Anggito007/hidroponik-iot/skematik.md

# Panduan Skematik HydroIoT
## Referensi Wiring untuk EasyEDA / Fritzing

---

# BAGIAN 1 — DESAIN SISTEM NODE (LENGKAP)

## 1.1 Diagram Sistem Node (Koneksi Fisik)

```
                        ┌─────────────────────────────────────────────────────────────────┐
                        │                    SISTEM NODE HIDROPONIK                        │
                        │                  (Node 1 ADDL=0x02 / Node 2 ADDL=0x03)          │
                        └─────────────────────────────────────────────────────────────────┘

┌──────────────────┐    ┌──────────────────────────────────────────────────────────────────┐
│   ADAPTOR 9V DC  │    │                    ESP32 EXPANSION BOARD                         │
│                  │    │                                                                   │
│  (+) ────────────┼───►│ VIN                                                              │
│  (-) ────────────┼───►│ GND ◄─────────────────────────────────── PSU 12V (-)            │
└──────────────────┘    │                                                                   │
                        │  3.3V ─────────────────────────────────────────────────────┐     │
                        │  5V   ──────────────────────────────────────────────────┐  │     │
                        │  GND  ──────────────────────────────────────────────┐   │  │     │
                        │                                                     │   │  │     │
                        │  ┌──────────────────────────────────────────────┐  │   │  │     │
                        │  │              LoRa E32-433T20D                 │  │   │  │     │
                        │  │  VCC ◄─────────────────────────────────── 5V ┼──┘   │  │     │
                        │  │  GND ◄──────────────────────────────────────GND     │  │     │
                        │  │  RXD ◄──── GPIO17 (TX2)                      │      │  │     │
                        │  │  TXD ────► GPIO16 (RX2)                      │      │  │     │
                        │  │  AUX ────► GPIO18                             │      │  │     │
                        │  │  M0  ◄──── GPIO21                             │      │  │     │
                        │  │  M1  ◄──── GPIO22                             │      │  │     │
                        │  └──────────────────────────────────────────────┘      │  │     │
                        │                                                         │  │     │
                        │  ┌──────────────────────────────────────────────┐      │  │     │
                        │  │                   DHT22                       │      │  │     │
                        │  │  Pin1 VCC  ◄──────────────────────────── 3.3V┼──────┘  │     │
                        │  │  Pin2 DATA ────► GPIO4 (INPUT_PULLUP)         │         │     │
                        │  │  Pin3 NC   (tidak disambung)                  │         │     │
                        │  │  Pin4 GND  ◄────────────────────────────────GND        │     │
                        │  └──────────────────────────────────────────────┘         │     │
                        │                                                            │     │
                        │  ┌──────────────────────────────────────────────┐         │     │
                        │  │              HC-SR04 Ultrasonik               │         │     │
                        │  │  VCC  ◄──────────────────────────────────── 5V┼─────────┘     │
                        │  │  GND  ◄────────────────────────────────────GND               │
                        │  │  TRIG ◄──── GPIO32                            │               │
                        │  │  ECHO ──── [R1:1kΩ] ──── GPIO33               │               │
                        │  │                │                               │               │
                        │  │            [R2:2kΩ]                            │               │
                        │  │                │                               │               │
                        │  │               GND                              │               │
                        │  └──────────────────────────────────────────────┘               │
                        │                                                                   │
                        │  ┌──────────────────────────────────────────────┐               │
                        │  │            Modul TDS Sensor                   │               │
                        │  │  VCC  ◄──────────────────────────────────── 5V│               │
                        │  │  GND  ◄────────────────────────────────────GND│               │
                        │  │  AOUT ────► GPIO35 (ADC)                      │               │
                        │  └──────────────────────────────────────────────┘               │
                        │                                                                   │
                        │  ┌──────────────────────────────────────────────┐               │
                        │  │          Modul Relay 3 Channel                │               │
                        │  │  VCC ◄───────────────────────────────────── 5V│               │
                        │  │  GND ◄─────────────────────────────────────GND│               │
                        │  │  IN1 ◄──── GPIO23 (Pompa Air)                 │               │
                        │  │  IN2 ◄──── GPIO25 (Pompa Nutrisi)             │               │
                        │  │  IN3 ◄──── GPIO26 (Kipas)                     │               │
                        │  │                                                │               │
                        │  │  COM1 ◄─── PSU 12V (+) ───────────────────────┼───────────────┼──┐
                        │  │  COM2 ◄─── PSU 12V (+)                        │               │  │
                        │  │  COM3 ◄─── PSU 12V (+)                        │               │  │
                        │  │                                                │               │  │
                        │  │  NO1 ──────────────────────────────────────────┼───► (+) Pompa Air
                        │  │  NO2 ──────────────────────────────────────────┼───► (+) Pompa Nutrisi
                        │  │  NO3 ──────────────────────────────────────────┼───► (+) Kipas
                        │  └──────────────────────────────────────────────┘               │  │
                        └───────────────────────────────────────────────────────────────────┘  │
                                                                                               │
┌──────────────────┐                                                                           │
│   PSU 12V DC     │                                                                           │
│  (+) ────────────┼───────────────────────────────────────────────────────────────────────────┘
│  (-) ────────────┼───► GND ESP32 (Common GND)
│                  │───► (-) Pompa Air
│                  │───► (-) Pompa Nutrisi
└──────────────────┘───► (-) Kipas
```

---

## 1.2 Diagram Koneksi Voltage Divider HC-SR04

```
HC-SR04 ECHO (5V)
        │
       [R1: 1kΩ]
        │
        ├──────────────► GPIO33 ESP32 (3.3V max)
        │
       [R2: 2kΩ]
        │
       GND

Vout = 5V × 2000/(1000+2000) = 3.33V ✓
```

---

## 1.3 Diagram Power Distribution Node

```
┌─────────────────────────────────────────────────────────┐
│                  DISTRIBUSI DAYA NODE                    │
│                                                          │
│  ADAPTOR 9V                                              │
│  (+) ──────────────────────────────► VIN ESP32           │
│  (-) ──────┬───────────────────────► GND ESP32           │
│            │                                             │
│  PSU 12V   │                                             │
│  (+) ──────┼──────────────────────► COM Relay 1,2,3      │
│  (-) ──────┘ (COMMON GND)                                │
│            │                                             │
│            ├──────────────────────► (-) Pompa Air        │
│            ├──────────────────────► (-) Pompa Nutrisi    │
│            └──────────────────────► (-) Kipas            │
│                                                          │
│  Board Ekspansi ESP32 output:                            │
│  5V  ──► LoRa E32, HC-SR04, TDS Sensor, Relay           │
│  3.3V──► DHT22                                           │
└─────────────────────────────────────────────────────────┘
```

---

# BAGIAN 2 — DESAIN SISTEM GATEWAY

## 2.1 Diagram Sistem Gateway (Koneksi Fisik)

```
                        ┌─────────────────────────────────────────────────────────────────┐
                        │                       SISTEM GATEWAY                             │
                        │                    (ADDL=0x01, WiFi → Firebase)                 │
                        └─────────────────────────────────────────────────────────────────┘

┌──────────────────┐    ┌──────────────────────────────────────────────────────────────────┐
│   ADAPTOR 9V DC  │    │                    ESP32 EXPANSION BOARD                         │
│                  │    │                                                                   │
│  (+) ────────────┼───►│ VIN                                                              │
│  (-) ────────────┼───►│ GND                                                              │
└──────────────────┘    │                                                                   │
                        │  5V ────────────────────────────────────────────────────────┐    │
                        │  GND ───────────────────────────────────────────────────┐   │    │
                        │                                                         │   │    │
                        │  ┌──────────────────────────────────────────────┐      │   │    │
                        │  │              LoRa E32-433T20D                 │      │   │    │
                        │  │  VCC ◄─────────────────────────────────── 5V ┼──────┘   │    │
                        │  │  GND ◄──────────────────────────────────────GND         │    │
                        │  │  RXD ◄──── GPIO17 (TX2)                      │          │    │
                        │  │  TXD ────► GPIO16 (RX2)                      │          │    │
                        │  │  AUX ────► GPIO18                             │          │    │
                        │  │  M0  ◄──── GPIO21                             │          │    │
                        │  │  M1  ◄──── GPIO22                             │          │    │
                        │  └──────────────────────────────────────────────┘          │    │
                        │                                                             │    │
                        │  ┌──────────────────────────────────────────────┐          │    │
                        │  │           WiFi Internal ESP32                 │          │    │
                        │  │  SSID: Tenda                                  │          │    │
                        │  │  Fungsi: Push sensor data ke Firebase         │          │    │
                        │  │          Poll relay command dari Firebase     │          │    │
                        │  └──────────────────────────────────────────────┘          │    │
                        └─────────────────────────────────────────────────────────────┘    │
```

---

## 2.2 Diagram Power Distribution Gateway

```
┌─────────────────────────────────────────────────────────┐
│               DISTRIBUSI DAYA GATEWAY                    │
│                                                          │
│  ADAPTOR 9V                                              │
│  (+) ──────────────────────────────► VIN ESP32           │
│  (-) ──────────────────────────────► GND ESP32           │
│                                                          │
│  Board Ekspansi ESP32 output:                            │
│  5V  ──► LoRa E32                                        │
│  3.3V──► GPIO (internal)                                 │
└─────────────────────────────────────────────────────────┘
```

---

# BAGIAN 3 — DESAIN KONEKSI PER KOMPONEN

## 3.1 ESP32 ↔ LoRa E32-433T20D

```
┌─────────────────┐              ┌─────────────────────┐
│      ESP32      │              │   LoRa E32-433T20D   │
│                 │              │                      │
│ GPIO17 (TX2) ───┼─────────────►│ RXD                  │
│ GPIO16 (RX2) ◄──┼──────────────│ TXD                  │
│ GPIO18       ◄──┼──────────────│ AUX                  │
│ GPIO21       ───┼─────────────►│ M0                   │
│ GPIO22       ───┼─────────────►│ M1                   │
│ 5V           ───┼─────────────►│ VCC                  │
│ GND          ───┼─────────────►│ GND                  │
└─────────────────┘              └─────────────────────┘
```

## 3.2 ESP32 ↔ DHT22

```
┌─────────────────┐              ┌─────────────────────┐
│      ESP32      │              │        DHT22         │
│                 │              │  (tampak depan)      │
│ 3.3V         ───┼─────────────►│ Pin 1 (VCC)          │
│ GPIO4        ◄──┼──────────────│ Pin 2 (DATA)         │
│ -               │    (skip)    │ Pin 3 (NC)           │
│ GND          ───┼─────────────►│ Pin 4 (GND)          │
└─────────────────┘              └─────────────────────┘

Catatan: Internal pull-up ESP32 aktif di firmware
         Tidak perlu resistor pull-up eksternal
```

## 3.3 ESP32 ↔ HC-SR04

```
┌─────────────────┐              ┌─────────────────────┐
│      ESP32      │              │      HC-SR04         │
│                 │              │                      │
│ 5V           ───┼─────────────►│ VCC                  │
│ GND          ───┼─────────────►│ GND                  │
│ GPIO32       ───┼─────────────►│ TRIG                 │
│                 │              │ ECHO ──[1kΩ]──┐      │
│ GPIO33       ◄──┼──────────────┘               │      │
│                 │                          [2kΩ]│      │
│ GND          ───┼──────────────────────────────┘      │
└─────────────────┘              └─────────────────────┘
```

## 3.4 ESP32 ↔ TDS Sensor

```
┌─────────────────┐              ┌─────────────────────┐
│      ESP32      │              │   Modul TDS Sensor   │
│                 │              │                      │
│ 5V           ───┼─────────────►│ VCC                  │
│ GND          ───┼─────────────►│ GND                  │
│ GPIO35       ◄──┼──────────────│ AOUT                 │
└─────────────────┘              └─────────────────────┘

Catatan: GPIO35 = ADC input only, output TDS max ~2.3V
         Tidak perlu voltage divider
```

## 3.5 ESP32 ↔ Modul Relay 3 Channel

```
┌─────────────────┐              ┌─────────────────────────────┐
│      ESP32      │              │    Modul Relay 3 Channel     │
│                 │              │    (Active LOW)              │
│ 5V           ───┼─────────────►│ VCC                         │
│ GND          ───┼─────────────►│ GND                         │
│ GPIO23       ───┼─────────────►│ IN1 (Relay 1 — Pompa Air)   │
│ GPIO25       ───┼─────────────►│ IN2 (Relay 2 — Pompa Nutrisi│
│ GPIO26       ───┼─────────────►│ IN3 (Relay 3 — Kipas)       │
└─────────────────┘              └─────────────────────────────┘
```

## 3.6 Relay ↔ Beban 12V

```
PSU 12V (+) ──────────────────────────────────────────────────┐
                                                               │
              ┌────────────────────────────────────────────┐  │
              │  RELAY 1                                    │  │
              │  COM ◄────────────────────────────────────── ┘  │
              │  NO  ──────────────────────────────────────────►(+) Pompa Air
              └────────────────────────────────────────────┘

              ┌────────────────────────────────────────────┐
              │  RELAY 2                                    │
              │  COM ◄──── PSU 12V (+)                      │
              │  NO  ──────────────────────────────────────►(+) Pompa Nutrisi
              └────────────────────────────────────────────┘

              ┌────────────────────────────────────────────┐
              │  RELAY 3                                    │
              │  COM ◄──── PSU 12V (+)                      │
              │  NO  ──────────────────────────────────────►(+) Kipas
              └────────────────────────────────────────────┘

PSU 12V (-) ──────────────────────────────────────────────────►(-) Pompa Air
                                                              ──►(-) Pompa Nutrisi
                                                              ──►(-) Kipas
```

---

# BAGIAN 4 — TABEL KONEKSI LENGKAP

## 4.1 Node 1 & Node 2

| No | Dari | Pin | Ke | Pin | Tegangan |
|---|---|---|---|---|---|
| 1 | Adaptor 9V | (+) | ESP32 Board | VIN | 9V |
| 2 | Adaptor 9V | (-) | ESP32 Board | GND | - |
| 3 | PSU 12V | (+) | Relay | COM 1,2,3 | 12V |
| 4 | PSU 12V | (-) | ESP32 Board | GND | - |
| 5 | PSU 12V | (-) | Pompa Air | (-) | - |
| 6 | PSU 12V | (-) | Pompa Nutrisi | (-) | - |
| 7 | PSU 12V | (-) | Kipas | (-) | - |
| 8 | ESP32 | 5V | LoRa E32 | VCC | 5V |
| 9 | ESP32 | GND | LoRa E32 | GND | - |
| 10 | ESP32 | GPIO17 | LoRa E32 | RXD | 3.3V |
| 11 | ESP32 | GPIO16 | LoRa E32 | TXD | 3.3V |
| 12 | ESP32 | GPIO18 | LoRa E32 | AUX | 3.3V |
| 13 | ESP32 | GPIO21 | LoRa E32 | M0 | 3.3V |
| 14 | ESP32 | GPIO22 | LoRa E32 | M1 | 3.3V |
| 15 | ESP32 | 3.3V | DHT22 | Pin1 VCC | 3.3V |
| 16 | ESP32 | GND | DHT22 | Pin4 GND | - |
| 17 | ESP32 | GPIO4 | DHT22 | Pin2 DATA | 3.3V |
| 18 | ESP32 | 5V | HC-SR04 | VCC | 5V |
| 19 | ESP32 | GND | HC-SR04 | GND | - |
| 20 | ESP32 | GPIO32 | HC-SR04 | TRIG | 3.3V |
| 21 | HC-SR04 | ECHO | R1 1kΩ → GPIO33 | - | 5V→3.3V |
| 22 | ESP32 | 5V | TDS Sensor | VCC | 5V |
| 23 | ESP32 | GND | TDS Sensor | GND | - |
| 24 | ESP32 | GPIO35 | TDS Sensor | AOUT | 0-2.3V |
| 25 | ESP32 | 5V | Relay | VCC | 5V |
| 26 | ESP32 | GND | Relay | GND | - |
| 27 | ESP32 | GPIO23 | Relay | IN1 | 3.3V |
| 28 | ESP32 | GPIO25 | Relay | IN2 | 3.3V |
| 29 | ESP32 | GPIO26 | Relay | IN3 | 3.3V |
| 30 | Relay | NO1 | Pompa Air | (+) | 12V |
| 31 | Relay | NO2 | Pompa Nutrisi | (+) | 12V |
| 32 | Relay | NO3 | Kipas | (+) | 12V |

## 4.2 Gateway

| No | Dari | Pin | Ke | Pin | Tegangan |
|---|---|---|---|---|---|
| 1 | Adaptor 9V | (+) | ESP32 Board | VIN | 9V |
| 2 | Adaptor 9V | (-) | ESP32 Board | GND | - |
| 3 | ESP32 | 5V | LoRa E32 | VCC | 5V |
| 4 | ESP32 | GND | LoRa E32 | GND | - |
| 5 | ESP32 | GPIO17 | LoRa E32 | RXD | 3.3V |
| 6 | ESP32 | GPIO16 | LoRa E32 | TXD | 3.3V |
| 7 | ESP32 | GPIO18 | LoRa E32 | AUX | 3.3V |
| 8 | ESP32 | GPIO21 | LoRa E32 | M0 | 3.3V |
| 9 | ESP32 | GPIO22 | LoRa E32 | M1 | 3.3V |

---

# BAGIAN 5 — DAFTAR KOMPONEN (BOM)

## Per Node (×2)

| No | Komponen | Spesifikasi | Qty |
|---|---|---|---|
| 1 | ESP32 | DevKit + Board Ekspansi | 1 |
| 2 | LoRa E32 | E32-433T20D | 1 |
| 3 | DHT22 | Sensor Suhu & Kelembapan | 1 |
| 4 | HC-SR04 | Sensor Ultrasonik | 1 |
| 5 | TDS Sensor | Modul Kuning | 1 |
| 6 | Modul Relay | 3 Channel, 5V, Active LOW | 1 |
| 7 | Resistor | 1kΩ (voltage divider ECHO) | 1 |
| 8 | Resistor | 2kΩ (voltage divider ECHO) | 1 |
| 9 | Adaptor | 9V DC | 1 |
| 10 | PSU | 12V DC | 1 |
| 11 | Pompa Air | 12V DC | 1 |
| 12 | Pompa Nutrisi | 12V DC | 1 |
| 13 | Kipas | 12V DC | 1 |

## Gateway (×1)

| No | Komponen | Spesifikasi | Qty |
|---|---|---|---|
| 1 | ESP32 | DevKit + Board Ekspansi | 1 |
| 2 | LoRa E32 | E32-433T20D | 1 |
| 3 | Adaptor | 9V DC | 1 |
