Anggito007/hidroponik-iot/docs/PANDUAN_WIRING_LENGKAP.html

# 🔌 PANDUAN WIRING LENGKAP

## Sistem HydroIoT dengan ESP32 + Relay + LM2596

Versi: 2.0 | Tanggal: Juli 2026

### Daftar Isi

- 1. Overview Sistem
- 2. Komponen yang Dibutuhkan
- 3. Distribusi Daya (Power Distribution)
- 4. Penjelasan VCC vs JD-VCC
- 5. Konfigurasi Wiring yang Direkomendasikan
- 6. Wiring Ground (GND Bersama)
- 7. Wiring Beban 12V (Pompa & Kipas)
- 8. Masalah Umum & Solusi
- 9. Best Practices & Tips
- 10. Checklist Sebelum Nyala

## 1. Overview Sistem

Sistem HydroIoT menggunakan konfigurasi power sebagai berikut:

- PSU Utama: 12V DC
- Step-Down: LM2596 (12V → 5V untuk relay & ESP32)
- ESP32: Mikrokontroler utama
- Relay Module: 3-channel, 5V, active LOW dengan optocoupler
- Beban: Pompa air 12V, Pompa nutrisi 12V, Kipas 12V

═══════════════════════════════════════════════════════════════════ ARSITEKTUR SISTEM DAYA ═══════════════════════════════════════════════════════════════════ ┌─────────────┐ │ PSU 12V DC │ │ (3A) │ └──────┬──────┘ │ │ 12V ├────────────────────────────────────────────────────┐ │ │ │ ┌────────▼────────┐ │ │ LM2596 │ │ │ Step-Down │ │ │ 12V → 5V │ │ └────────┬────────┘ │ │ │ 5V │ │ │ ┌────────────────────────────────┼────────────────────┐ │ │ │ │ │ │ ┌───────────▼───────────┐ │ │ │ │ │ │ │ │ │ ESP32 │ │ │ │ │ + Sensor/LoRa │ │ │ │ │ │ │ │ │ └───────────────────────┘ │ │ │ │ │ │ ┌──────────────────────────────────────┘ │ │ │ │ │ ┌──────▼──────┐ │ │ │ RELAY MODULE │ │ │ │ (3-Channel) │ │ │ └──────┬──────┘ │ │ │ │ │ COM/NO terminals │ │ │ │ │ ┌─────────┼─────────┬─────────┐ │ │ │ │ │ │ │ │ ┌─▼─┐ ┌─▼─┐ ┌─▼─┐ │ │ │P12V│ │P12V│ │F12V│ │ │ │Pump│ │Nutr│ │Fan │ │ │ └─┬─┘ └─┬─┘ └─┬─┘ │ │ │ │ │ └────────────────────┴────┴─────────┴─────────┘ GND (Common)

## 2. Komponen yang Dibutuhkan

No | Komponen | Spesifikasi | Qty | Fungsi
1 | PSU (Power Supply) | 12V DC, minimal 3A | 1 | Sumber daya utama
2 | Step-Down Converter | LM2596 (12V → 5V) | 1 | Menurunkan tegangan untuk ESP32 & relay
3 | ESP32 DevKit | WROOM-32 | 1 | Mikrokontroler utama
4 | Relay Module | 3-channel, 5V, active LOW | 1 | Kontrol beban 12V
5 | Pompa Air | 12V DC | 1 | Pengisian air
6 | Pompa Nutrisi | 12V DC | 1 | Dosing nutrisi
7 | Kipas | 12V DC | 1 | Pendingin
8 | Kabel & Konektor | AWG 22-18 (relay), AWG 24-22 (sinyal) | - | Koneksi antar komponen

## 3. Distribusi Daya (Power Distribution)

### 3.1 Alur Daya dari PSU

═══════════════════════════════════════════════════════════════════ DISTRIBUSI DAYA 12V ═══════════════════════════════════════════════════════════════════ PSU 12V (+) ──────────────────────────────────────────────────┐ │ │ │ ┌──────────────────────────────────────────────────────┤ │ │ │ │ │ LM2596 Input │ │ │ │ │ │ │ ┌────▼────┐ │ │ │ │ 12V IN │ │ │ │ │ LM2596 │ │ │ │ │ 5V OUT │ │ │ │ └────┬────┘ │ │ │ │ │ │ │ │ 5V │ │ │ │ │ │ │ ┌──────────┼──────────┐ │ │ │ │ │ │ │ │ │ │ │ │ │ │ │ ┌────▼────┐ ┌───▼────┐ ┌──▼───┐ │ │ │ │ ESP32 │ │ Relay │ │Relay │ │ │ │ │ VIN │ │ VCC │ │JD-VCC│ │ │ │ └─────────┘ └────────┘ └──────┘ │ │ │ │ │ │ COM Relay 1, 2, 3 │ │ │ (Pompa Air, Nutrisi, Kipas) │ │ │ │ │ └──────────────────────────────────────────────────────┘ │ │ │ │ │ PSU 12V (-) ──────────────────────────────────────────────────┘ │ │ GND BERSAMA (Common Ground) │ ├── GND LM2596 ├── GND ESP32 ├── GND Relay (logic side) ├── GND Relay (coil side) ├── GND Pompa Air (-) ├── GND Pompa Nutrisi (-) └── GND Kipas (-)

### 3.2 Detail Distribusi 5V dari LM2596

⚠️ PENTING: LM2596 harus bisa meng供应 minimal 1A untuk ESP32 + relay. Pastikan setting output = 5V sebelum digunakan!

═══════════════════════════════════════════════════════════════════ DISTRIBUSI 5V DARI LM2596 ═══════════════════════════════════════════════════════════════════ LM2596 Output (5V) │ │ ┌───────────────┼───────────────┬───────────────┐ │ │ │ │ │ │ │ │ ┌────▼────┐ ┌─────▼─────┐ ┌─────▼─────┐ ┌───▼───┐ │ ESP32 │ │ RELAY │ │ RELAY │ │Other │ │ VIN │ │ VCC │ │ JD-VCC │ │5V dev │ │ (5V) │ │ (logic) │ │ (coil) │ │ │ └────┬────┘ └─────┬─────┘ └─────┬─────┘ └───┬───┘ │ │ │ │ │ │ │ │ ┌────▼────┐ ┌─────▼─────┐ ┌─────▼─────┐ ┌───▼───┐ │ ESP32 │ │ RELAY │ │ RELAY │ │Other │ │ GND │ │ GND │ │ GND │ │GND │ └─────────┘ └───────────┘ └───────────┘ └───────┘ CATATAN: - ESP32 VIN = 5V dari LM2596 - Relay VCC = 5V untuk sirkuit optocoupler/logic (SEBELUM jumper) - Relay JD-VCC = 5V untuk koil relay (SESUDAH jumper)

## 4. Penjelasan VCC vs JD-VCC

### 4.1 Apa itu VCC dan JD-VCC?

💡 Info: Pada modul relay 5V dengan optocoupler, terdapat 2 jalur daya terpisah:

- VCC: Daya untuk sirkuit optocoupler dan driver transistor (logic side)
- JD-VCC: Daya untuk koil relay (coil side)

Pin | Fungsi | Tegangan | Arus | Catatan
VCC | Daya logic/optocoupler | 3.3V - 5V | ~10-20mA | Untuk LED optocoupler & transistor driver
JD-VCC | Daya koil relay | 5V | ~70-150mA per relay | Untuk medan magnet koil relay
GND (logic) | Ground sisi logic | 0V | - | Harus sama dengan ESP32 GND
GND (coil) | Ground sisi koil | 0V | - | Harus sama dengan GND logic

### 4.2 Jumper VCC-JD-VCC: Pasang atau Lepas?

🚨 KRITIS: Jumper VCC-JD-VCC menentukan apakah sirkuit relay terisolasi atau tidak!

#### Opsi A: Jumper DIPASANG (Tidak Direkomendasikan)

┌─────────────────────────────────────────────────────────────────┐
│                    JUMPER DIPASANG                             │
│                                                                 │
│   ESP32 5V ──────┬──────┬──────┬──────┬──────┬──────┐         │
│                   │      │      │      │      │      │         │
│              ┌────▼───┐  │  ┌───▼──┐ ┌─▼───┐ │  ┌───▼───┐    │
│              │ESP32   │  │  │Relay │ │Relay│ │  │Relay  │    │
│              │VIN     │  │  │VCC   │ │JD-VCC│ │  │ (all) │    │
│              └────────┘  │  └───┬──┘ └───┬──┘ │  └───┬───┘    │
│                          │      │        │     │      │         │
│   GND ───────────────────┴──────┴────────┴─────┴──────┘         │
│                                                                 │
│   ⚠️ MASALAH:                                                  │
│   1. Tidak ada isolasi antara ESP32 dan koil relay             │
│   2. Noise dari relay bisa mengganggu ESP32                    │
│   3. Arus koil relay mengambil dari ESP32 VIN                  │
│   4. Jika ESP32 crash, relay bisa nyala tiba-tiba              │
│                                                                 │
└─────────────────────────────────────────────────────────────────┘

#### Opsi B: Jumper DILEPAS (Direkomendasikan) ✓

┌─────────────────────────────────────────────────────────────────┐
│                    JUMPER DILEPAS                               │
│                                                                 │
│   ESP32 3.3V ────────────────────┬──────┬──────┐               │
│                                  │      │      │               │
│                             ┌────▼───┐  │  ┌───▼───┐          │
│                             │Relay   │  │  │Relay  │          │
│                             │VCC     │  │  │(logic)│          │
│                             └────┬───┘  │  └───┬───┘          │
│   GND (ESP32) ───────────────────┴──────┴──────┘               │
│                                                                 │
│   LM2596 5V ────────────────────┬──────┬──────┐               │
│                                  │      │      │               │
│                             ┌────▼───┐  │  ┌───▼───┐          │
│                             │Relay   │  │  │Relay  │          │
│                             │JD-VCC  │  │  │(coil) │          │
│                             └────┬───┘  │  └───┬───┘          │
│   GND (common) ─────────────────┴──────┴──────┘               │
│                                                                 │
│   ✅ KEUNGGULAN:                                               │
│   1. Optocoupler mengisolasi ESP32 dari koil relay            │
│   2. Noise relay tidak mengganggu ESP32                       │
│   3. ESP32 hanya mengupply arus kecil (~10mA)                 │
│   4. Lebih aman dan stabil                                    │
│                                                                 │
└─────────────────────────────────────────────────────────────────┘

## 5. Konfigurasi Wiring yang Direkomendasikan

✅ REKOMENDASI: Gunakan Opsi B (Jumper DILEPAS) dengan isolasi daya!

### 5.1 Wiring Lengkap (Jumper DILEPAS)

═══════════════════════════════════════════════════════════════════ WIRING LENGKAP - JUMPER VCC-JD-VCC DILEPAS ═══════════════════════════════════════════════════════════════════ ┌──────────────────────────────────────────────────────────────────┐ │ PSU 12V DC │ │ ┌─────────┐ │ │ │ 12V │ │ │ │ 3A │ │ │ └────┬────┘ │ │ │ │ │ (+12V)────┼────(-12V) │ │ │ │ │ │ │ │ COMMON GND │ │ │ │ │ └──────────────────────────────┼────────┼──────────────────────────┘ │ │ ┌─────────────────────┼────────┼─────────────────────────┐ │ │ │ │ │ ┌────▼────┐ │ │ │ │ LM2596 │ │ │ │ │ │ │ │ │ │ IN OUT │ │ │ │ │ 12V 5V │ │ │ │ └────┬────┘ │ │ │ │ │ │ │ 5V │ │ │ │ │ │ │ │ │ │ │ ┌────────────────┼────────┼─────────────────────┐ │ │ │ │ │ │ │ │ │ │ │ │ │ │ │ ┌────▼────┐ │ │ │ │ │ │ ESP32 │ │ │ │ │ │ │ │ │ │ │ │ │ │ VIN=5V │ │ │ │ │ │ │ GND─────┼───┘ │ │ │ │ │ │ │ │ │ │ │ GPIO25──┼──── IN1 (Relay) │ │ │ │ │ GPIO26──┼──── IN2 (Relay) │ │ │ │ │ GPIO27──┼──── IN3 (Relay) │ │ │ │ └─────────┘ │ │ │ │ │ │ │ │ ┌────────────────────────────────────────┐ │ │ │ │ │ RELAY MODULE 3-CHANNEL │ │ │ │ │ │ │ │ │ │ │ │ VCC (3.3V) ◄─── ESP32 3.3V │ │ │ │ │ │ GND (logic) ◄─── ESP32 GND │ │ │ │ │ │ │ │ │ │ │ │ JD-VCC (5V) ◄─── LM2596 5V │◄──┘ │ │ │ │ GND (coil) ◄─── LM2596 GND │ │ │ │ │ │ │ │ │ │ │ │ IN1 ◄──── GPIO25 (Pompa Air) │ │ │ │ │ │ IN2 ◄──── GPIO26 (Pompa Nutrisi) │ │ │ │ │ │ IN3 ◄──── GPIO27 (Kipas) │ │ │ │ │ │ │ │ │ │ │ │ COM1 ◄──── (+12V dari PSU) │ │ │ │ │ │ COM2 ◄──── (+12V dari PSU) │ │ │ │ │ │ COM3 ◄──── (+12V dari PSU) │ │ │ │ │ │ │ │ │ │ │ │ NO1 ────► (+) Pompa Air │ │ │ │ │ │ NO2 ────► (+) Pompa Nutrisi │ │ │ │ │ │ NO3 ────► (+) Kipas │ │ │ │ │ └────────────────────────────────────────┘ │ │ │ │ │ │ │ │ (-) Pompa ──┐ │ │ │ │ (-) Kipas ──┼──► GND PSU (COMMON) │ │ │ └───────────────┘ │ │ │ │ │ └────────────────────────────────────────────────────┘ │ │

### 5.2 Penjelasan Setiap Koneksi

Dari | Ke | Kabel | Keterangan
PSU 12V (+) | LM2596 Input (+) | Kabel tebal (AWG 18) | Input daya step-down
PSU 12V (+) | Relay COM1, COM2, COM3 | Kabel tebal (AWG 18) | Daya beban 12V
PSU 12V (-) | LM2596 Input (-) | Kabel tebal (AWG 18) | Ground utama
LM2596 Output (+) | ESP32 VIN | Kabel standar (AWG 22) | Daya ESP32
LM2596 Output (+) | Relay JD-VCC | Kabel standar (AWG 22) | Daya koil relay
ESP32 3.3V | Relay VCC | Kabel tipis (AWG 24) | Daya logic relay
ESP32 GND | Relay GND (logic) | Kabel tipis (AWG 24) | Ground logic
LM2596 GND | Relay GND (coil) | Kabel standar (AWG 22) | Ground koil
ESP32 GPIO25 | Relay IN1 | Kabel tipis (AWG 24) | Sinyal kontrol Relay 1
ESP32 GPIO26 | Relay IN2 | Kabel tipis (AWG 24) | Sinyal kontrol Relay 2
ESP32 GPIO27 | Relay IN3 | Kabel tipis (AWG 24) | Sinyal kontrol Relay 3
Relay NO1 | Pompa Air (+) | Kabel tebal (AWG 18) | Switching beban
Relay NO2 | Pompa Nutrisi (+) | Kabel tebal (AWG 18) | Switching beban
Relay NO3 | Kipas (+) | Kabel tebal (AWG 18) | Switching beban
Pompa Air (-) | PSU 12V (-) | Kabel tebal (AWG 18) | Ground beban
Pompa Nutrisi (-) | PSU 12V (-) | Kabel tebal (AWG 18) | Ground beban
Kipas (-) | PSU 12V (-) | Kabel tebal (AWG 18) | Ground beban

## 6. Wiring Ground (GND Bersama)

### 6.1 Mengapa Harus GND Bersama?

💡 Prinsip: Semua ground harus terhubung ke satu titik (common ground) agar referensi tegangan sama untuk semua komponen.

### 6.2 Diagram Common Ground

═══════════════════════════════════════════════════════════════════ COMMON GROUND (GND BERSAMA) ═══════════════════════════════════════════════════════════════════ PSU 12V (-) │ │ ┌─────────┴─────────┐ │ │ │ TITIK GND │ │ UTAMA │ │ │ └─────────┬─────────┘ │ ┌───────────────────┼───────────────────┐ │ │ │ │ │ │ ┌────▼────┐ ┌────▼────┐ ┌────▼────┐ │ LM2596 │ │ ESP32 │ │ RELAY │ │ GND │ │ GND │ │ GND │ └─────────┘ └─────────┘ └─────────┘ │ │ │ │ │ │ ┌────▼────┐ ┌────▼────┐ ┌────▼────┐ │ LOAD │ │ LOAD │ │ LOAD │ │ (-) │ │ (-) │ │ (-) │ │ Pompa │ │ Kipas │ │ Sensor │ └─────────┘ └─────────┘ └─────────┘ CATATAN: - Semua GND terhubung ke PSU 12V (-) - LM2596 GND = ESP32 GND = Relay GND = PSU GND - JANGAN buat GND terpisah (bisa menyebabkan noise)

### 6.3 Tips Wiring GND

⚠️ Penting:

- Gunakan kabel yang cukup tebal untuk GND (AWG 18 atau lebih tebal)
- Hindari GND loop (lingkaran ground yang tidak perlu)
- Pastikan semua koneksi GND kencang dan tidak longgar
- Gunakan terminal block atau solder untuk koneksi yang reliable

## 7. Wiring Beban 12V (Pompa & Kipas)

### 7.1 Konfigurasi Relay untuk Beban DC

═══════════════════════════════════════════════════════════════════ WIRING RELAY UNTUK BEBAN 12V DC ═══════════════════════════════════════════════════════════════════ PSU 12V (+) ──────────────────────────────────────────────────┐ │ │ │ ┌───────────────────────────────────────────────┤ │ │ │ │ ┌────┴────┐ ┌────┴────┐ │ │ RELAY │ │ RELAY │ │ │ COM1 │ │ COM2 │ │ └────┬────┘ └────┬────┘ │ │ │ │ ┌────▼────┐ ┌────▼────┐ │ │ NO1 │ │ NO2 │ │ └────┬────┘ └────┬────┘ │ │ │ │ │ │ │ ┌────▼────────────┐ ┌───────▼─────────┐ │ │ POMPA AIR │ │ POMPA NUTRISI │ │ │ 12V DC │ │ 12V DC │ │ │ │ │ │ │ │ (+) ◄────────┤ ├────────► (+) │ │ │ (-) ─────────┤ ├─────────► (-) │ │ └─────────────────┘ └─────────────────┘ │ │ │ │ │ │ │ └───────────────────┬───────────────────────────┘ │ │ │ │ PSU 12V (-) ──────────────────────┘ KONFIGURASI: - COM (Common) → ke PSU 12V (+) - NO (Normally Open) → ke Beban (+) - NC (Normally Closed) → tidak dipakai - Beban (-) → ke PSU 12V (-) CATATAN: - Gunakan terminal NO (Normally Open) - Relay OFF = Pompa/Kipas MATI - Relay ON = Pompa/Kipas NYALA - Active LOW: GPIO LOW = Relay ON

### 7.2 Flyback Diode (Opsional tapi Direkomendasikan)

⚠️ Untuk motor DC: Pasang flyback diode (1N4007) paralel dengan terminal COM-NO untuk melindungi relay dari voltage spike saat motor dimatikan.

                    RELAY TERMINALS
                    ┌─────────────┐
                    │             │
    PSU 12V (+) ───►│ COM    NO   │───► (+) Motor
                    │             │
                    │      ┌──┐   │
                    │      │D │   │  ← Flyback Diode (1N4007)
                    │      │▲ │   │     Anode ke NO, Cathode ke COM
                    │      └──┘   │
                    └─────────────┘

## 8. Masalah Umum & Solusi

Masalah | Penyebab | Solusi
ESP32 Reset Random | Noise dari relay mengganggu power ESP32 | Lepas jumper VCC-JD-VCC Pasang kapasitor 100µF di VIN ESP32 Gunakan power supply terpisah untuk relay
Relay Tidak Bisa Switch | Arus tidak cukup atau koneksi longgar | Cek koneksi JD-VCC ke 5V Pastikan GND terhubung dengan baik Uk tegangan di JD-VCC (harus 5V)
Relay Selalu ON | Sinyal control salah atau pull-up/internal | Cek apakah active LOW atau HIGH Pastikan GPIO diatur ke OUTPUT Set GPIO HIGH untuk OFF (active LOW)
LoRa Tidak Stabil | Noise EMI dari kabel relay | Jauhkan antena LoRa dari kabel relay Gunakan kabel shielded untuk LoRa Pasang kapasitor 100nF di VCC LoRa
Sensor TDS Noise | Ground loop atau noise power | Pastikan semua GND bersama Pasang kapasitor 10µF di VCC sensor Gunakan kabel twisted pair untuk analog

## 9. Best Practices & Tips

### 9.1 Noise Reduction

═══════════════════════════════════════════════════════════════════ NOISE REDUCTION TECHNIQUES ═══════════════════════════════════════════════════════════════════ 1. KAPASITOR DECOUPLING ───────────────────────── - 100µF electrolytic di VIN ESP32 - 100nF ceramic di VCC relay - 10µF di VCC sensor analog 2. FLYBACK DIODE ───────────────────────── - 1N4007 paralel dengan koil relay - Anode ke NO/NC, Cathode ke COM - Melindungi dari voltage spike 3. SEPARASI DAYA ───────────────────────── - Relay coil: LM2596 5V - Relay logic: ESP32 3.3V - Sensor: ESP32 3.3V/5V 4. LAYOUT KABEL ───────────────────────── - Pisahkan kabel power dari sinyal - Minimal 5cm jarak antara kabel relay dan LoRa - Gunakan kabel twisted pair untuk sinyal analog

### 9.2 Tips Wiring

✅ Best Practices:

- Kabel: Gunakan kabel berwarna berbeda (merah=VCC, hitam=GND, lain=sinyal)
- Koneksi: Gunakan terminal block atau solder, hindari breadboard untuk produksi
- Label: Beri label pada setiap kabel dan terminal
- Dokumentasi: Foto semua wiring sebelum ditutup
- Testing: Test satu per satu komponen sebelum digabung
- Safety: Selalu matikan PSU saat modifikasi wiring

### 9.3 Kapasitor yang Direkomendasikan

Lokasi | Tipe | Nilai | Fungsi
ESP32 VIN | Electrolytic | 100µF / 16V | Filter noise low frequency
ESP32 VIN | Ceramic | 100nF | Filter noise high frequency
Relay JD-VCC | Ceramic | 100nF | Filter switching noise
Sensor VCC | Electrolytic | 10µF / 10V | Stabilisasi tegangan sensor
LoRa VCC | Ceramic | 100nF | Filter noise untuk komunikasi

## 10. Checklist Sebelum Nyala

✅ Checklist Lengkap:

✓ | Item | Catatan
☐ | Jumper VCC-JD-VCC DILEPAS | Kedua modul relay harus dilepas
☐ | ESP32 VCC ke Relay VCC (logic) | 3.3V dari ESP32
☐ | LM2596 ke Relay JD-VCC (coil) | 5V dari LM2596
☐ | Semua GND terhubung | ESP32, Relay, LM2596, PSU
☐ | COM relay ke PSU 12V (+) | Untuk beban pompa/kipas
☐ | NO relay ke Beban (+) | Pompa & kipas
☐ | Beban (-) ke PSU 12V (-) | Ground beban
☐ | GPIO relay ke IN1/IN2/IN3 | GPIO 25, 26, 27
☐ | LoRa VCC ke 3.3V | BUKAN 5V!
☐ | LM2596 output = 5V | Uk sebelum digunakan
☐ | Kabel tidak ada yang short | Cek dengan multimeter
☐ | Semua solder kencang | Tidak ada yang loose
☐ | Antena LoRa terpasang | Jangan nyalakan tanpa antena!
☐ | Firmware sudah diupload | Cek Serial Monitor

💡 Tips Final:

- Nyalakan PSU tanpa beban terlebih dahulu
- Uk tegangan di semua titik sebelum pasang beban
- Test relay satu per satu dari Serial Monitor
- Jika ada masalah, matikan PSU dan cek wiring

HydroIoT System | Panduan Wiring Lengkap v2.0
Dokumen ini dapat dicetak ke PDF dari browser (Ctrl+P → Save as PDF)
