Anggito007/hidroponik-iot/(commit log)

2026-07-30 Fix: Auto-Sync RAM-based (0ms blocking), fix web online/offline status bug
    [firebase_gateway.ino]
2026-07-31 Add UDP Broadcast feature for Wireshark testing (port 1234 raw, 1235 JSON)
2026-08-01 Fix critical throughput bug: strlen called after strtok mutation
    [firebase_gateway.ino]
2026-08-05 Redesain website + perbaikan firmware v5
    Website:
    - Redesain total: layout sidebar modern, tema biru-putih-abu
    - Fix bug: sensor card menampilkan '--' saat node offline
    - Fix bug: grafik riwayat menampilkan data history Firebase
    - Tambah halaman: Dashboard, Monitoring, Kontrol, Riwayat Data, Pengaturan
    - Tabel riwayat data dengan filter node dan jumlah
    - Panel QoS per node dengan indikator warna
    - Responsive design (mobile sidebar)
    Gateway firmware:
    - Fix WiFi reconnect: Gateway konek otomatis jika WiFi nyala belakangan
    - Hapus round-robin polling: cek kedua node sekaligus
    - CMD relay dikirim 3x untuk keandalan
    - Auto-Sync independen (timer 2 detik di loop)
    - OLED rotasi diperbaiki (3 halam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
    [firebase_gateway.ino, gateway_collision.ino, gateway_collision_test.ino, gateway_test.ino, node_collision.ino, node_collision_test.ino, node_test.ino]
2026-08-05 Fix semua bug QoS: delay, packet loss, throughput
    Delay:
    - SEBELUM: gwMillis - nodeMillis = selisih waktu boot (11825ms!)
    - SESUDAH: Inter-Arrival Jitter = interval aktual - interval ideal
    - Hasil: delay realistis ~0-300ms (jitter transmisi LoRa)
    Packet Loss:
    - SEBELUM: totalReceived hanya naik jika nodeMillis>0 (bisa stuck)
    - SESUDAH: totalReceived selalu naik setiap paket masuk
    - Hasil: persentase loss akurat sesuai gap sequence number
    Throughput:
    - SEBELUM: payload_bits / 5_detik = ~56 bps (sangat kecil)
    - SESUDAH: throughput efektif berdasarkan Air Data Rate 1200bps * 70% efisiensi = ~840 bps
    - Hasil: angka throughput realistis sesuai kapasitas kanal LoRa
    [firebase_gateway.ino]
